DevangChaturvedi-git/PHANTOM/simulation/ambient_referenced_detector_draft1.asc

C1: cap; 100nF
C2: cap; 1�
I1: current; DC 10u PULSE(0 50u 1m 1u 1u 10u 5m)
R1: res; 10k
R2: res; 100k
Named nets: 0, V_hunter, v_ambient
.tran 0 20ms 0 1us
