DevangChaturvedi-git/PHANTOM/simulation/peak_hold_pulse_stretcher_draft2.asc

B1: bv; V=if(V(Vh) > 0.1, 5, 0)
C1: cap; 100nF
C2: cap; 1�
D1: diode; 1N4148
I1: current; DC 10u PULSE(0 50u 1m 1u 1u 10u 5m)
M1: nmos
R1: res; 10k
R2: res; 470k
R4: Res; 3.5
V1: Voltage; 5
Named nets: 0, Vh, Va
.tran 0 20ms 0 1us
.model SFH4715AS D(Is=1e-18 Rs=0.5 N=1.5 Cjo=50p)
